f1oat/EATC-120/doc/EATC-120-pinout.xlsx

Sheet: Pinout
Pin | Color | Signal
1 |  | GND
2 |  | MODBUS A
3 |  | MODBUS B
4 |  | 24V input
5 |  | 0V input
6 |  | MOTOR
7 |  | MOTOR
8 | brown | 24V sensors
9 | green | 0V sensors
10 | blue | S4
11 | pink | S3
12 | yellow | S2
13 | grey | S1

Sheet: Label
 |  | Print at 20% scale
GND | 1
MODBUS A | 2 | EATC-120 | EmcoTurn 120/220 Automatic tool changer driver
MODBUS B | 3
24V input | 4
0V input | 5
MOTOR | 6
MOTOR | 7
24V sensors | 8
0V sensors | 9
S4 | 10
S3 | 11
S2 | 12
S1 | 13
