f1oat/EATC-120/pictures/EATC-120-3D.png

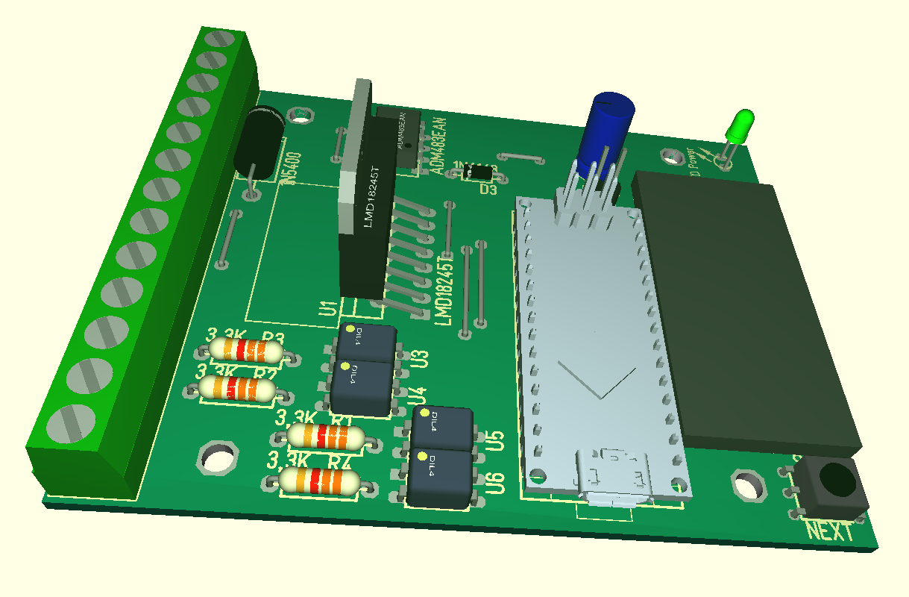
pictures/EATC-120-3D.png
