f1oat/EATC-120/pictures/EATC-120-PCB.png

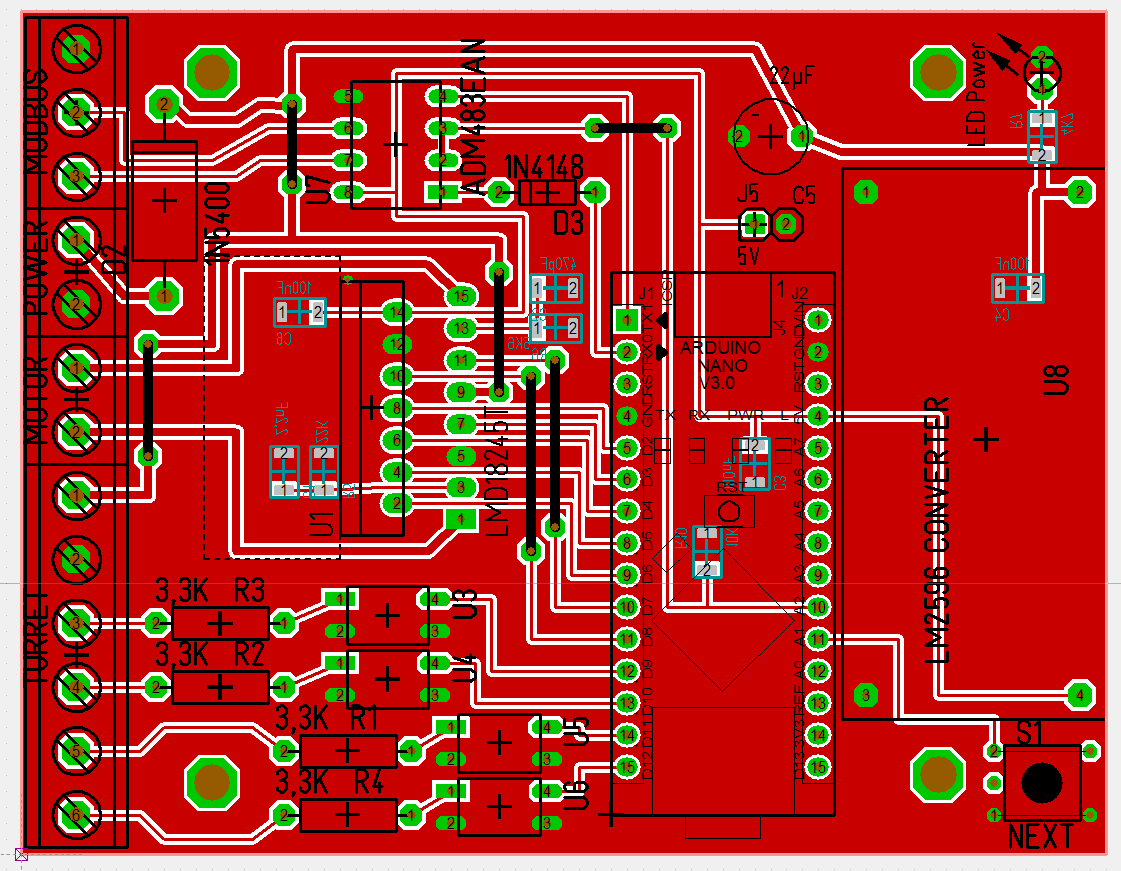
pictures/EATC-120-PCB.png
