f1oat/EATC-120/pictures/IMG_2227.JPG

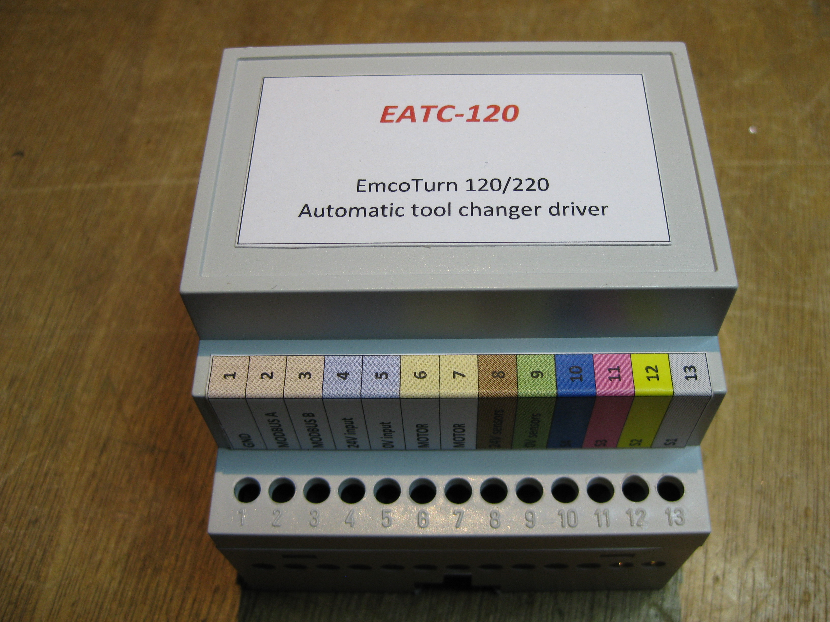
pictures/IMG_2227.JPG
