f1oat/EATC-120/pictures/IMG_2228.JPG

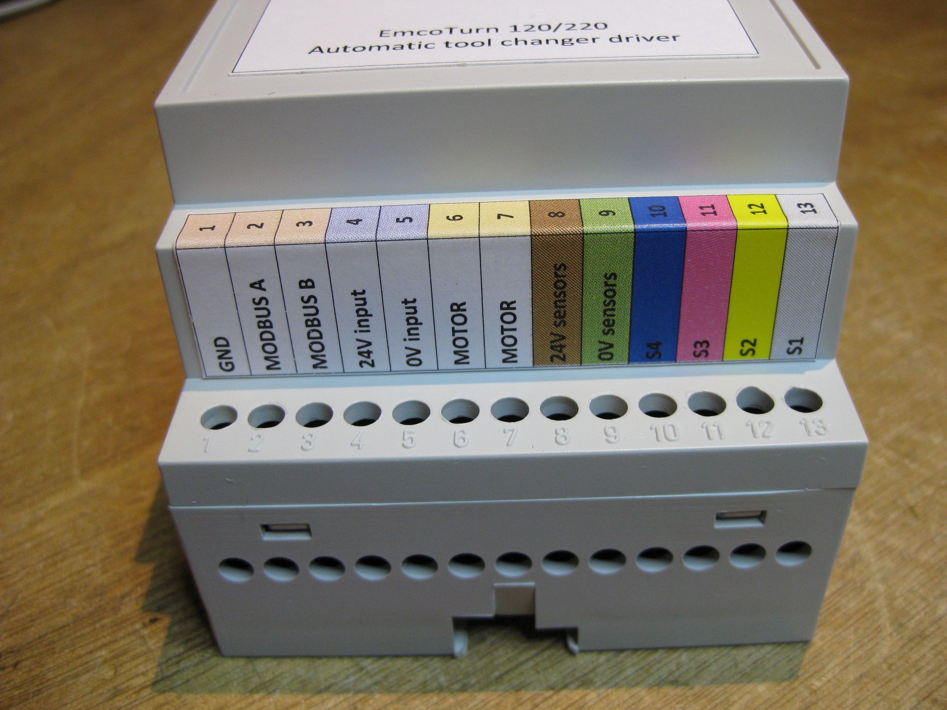
pictures/IMG_2228.JPG
