f1oat/EATC-120/pictures/IMG_2229.JPG

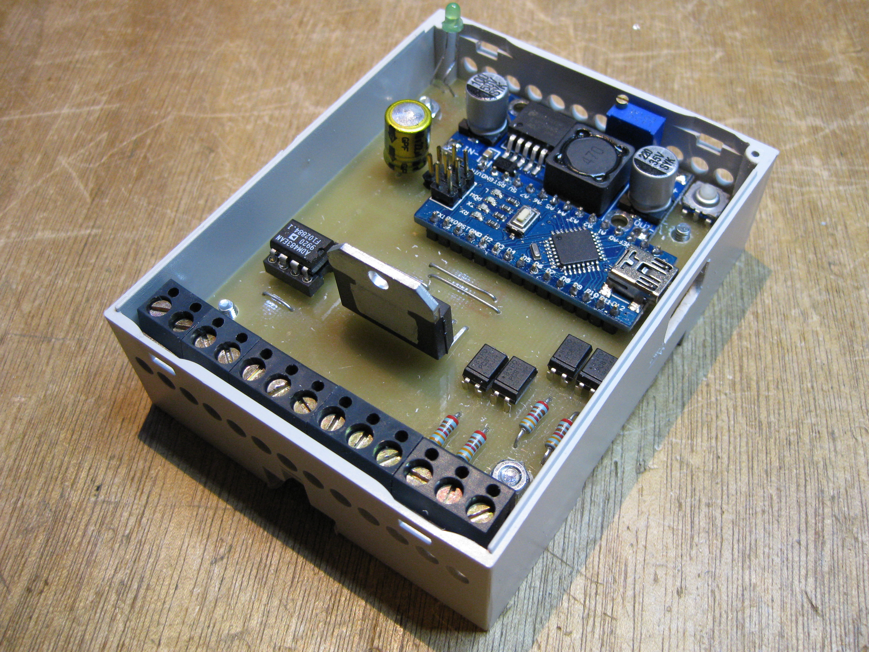
pictures/IMG_2229.JPG
