f1oat/EATC-120/pictures/IMG_2230.JPG

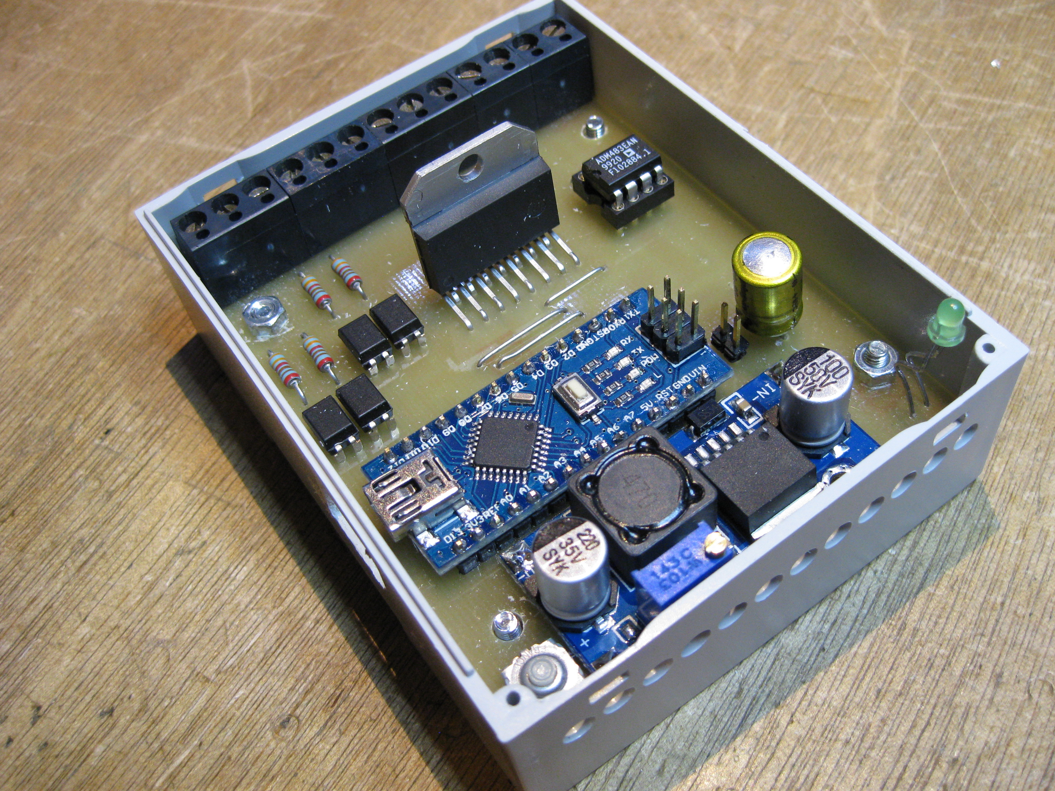
pictures/IMG_2230.JPG
