f1oat/EATC-120/electronics/EATC120 pcb.pdf

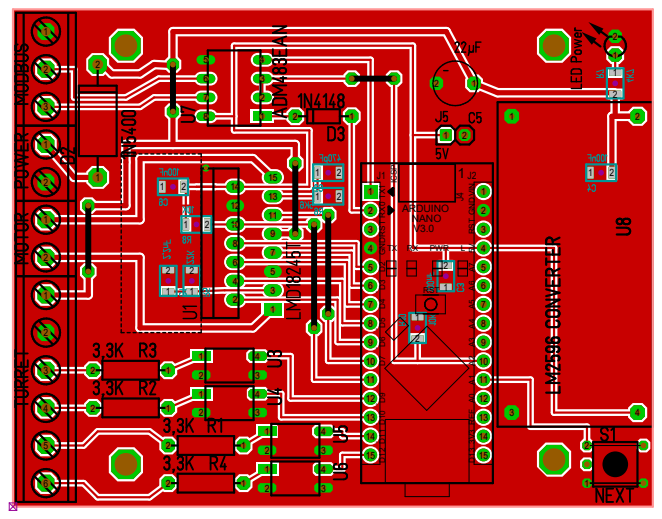
[picture p8: page 1]
NANO; ARDUINO L; RST; PWR ICSP; 1 VIN GND RST 5V A⁷ A⁶ A⁵ A⁴ A³ A² A¹ A⁰ REF 3V³ D¹² D¹¹ D¹⁰ D⁹ D⁷ D⁶ D⁵ D⁴ D³ D² GNDRST RX⁰ TX¹; D¹³

14
12 | 13
