f1oat/EATC-120/electronics/EATC120 schematic.pdf

## 18 KHz 3.35A max +5V

# 1⁴⁷⁰pF C²

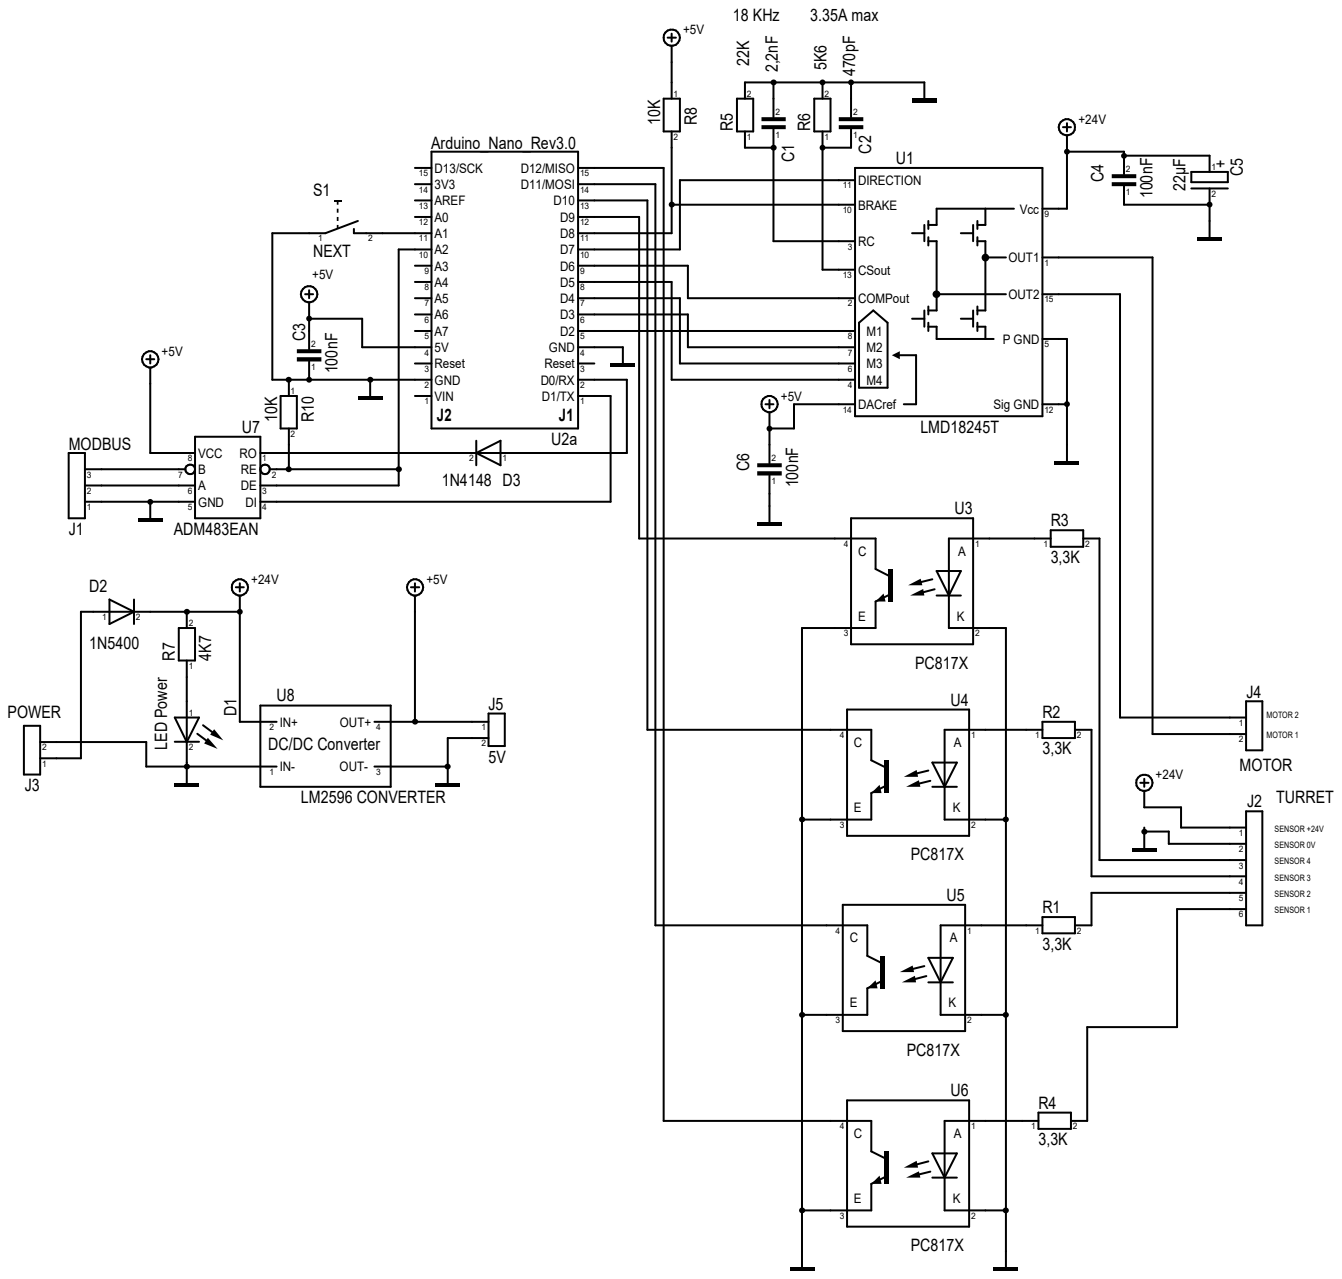
[picture p9: page 1]

SENSOR 0V
SENSOR 4 SENSOR 3 SENSOR 2 SENSOR 1
