f1oat/EATC-120/(commit log)

2016-12-05 Add protection diode for power supply + use diode to mix RX from USB and MODBUS
2016-12-06 Add pullup resistor for brake signal
2016-12-08 Add test HAL test config, pictures and label
    [EATC-120-pinout.xlsx, tool_test.hal, tool_test.ini]
2017-03-28 Store config in EEPROM
    [modbus.ini, tool_test.hal, tool_test.ini]
2017-03-28 Add Gerber files and schematic
